Nowie69/Eindproject-Robot-6ICW/README.md

De mappen zijn verdeeld per deel, map voor de website, voor code van de controle etc
Per map staat er een document om te zien wat er gedaan moet worden.
In elke map staat er ook de code en nodige documenten om de code te doen werken.
