Nowie69/Eindproject-Robot-6ICW/WebsiteV2/-Sjabloon-/hardware.html

Home Hardware Software Over Ons GitHub project (https://github.com/Nowie69/Eindproject-Robot-6ICW)

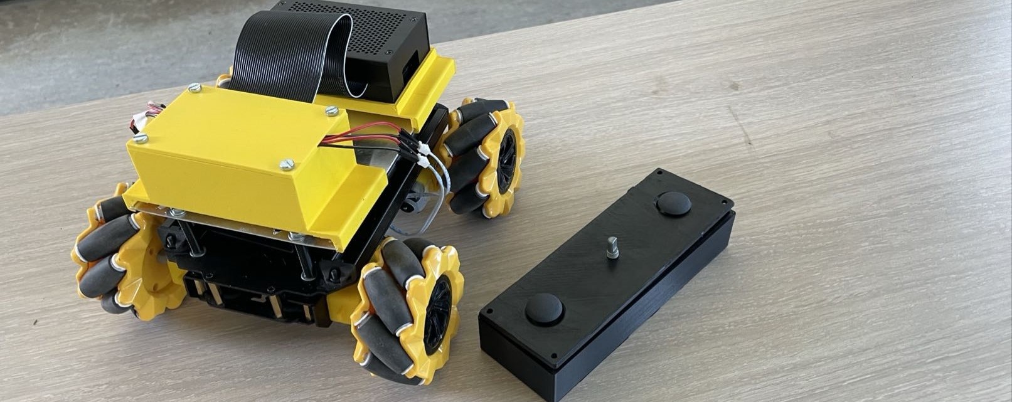
[picture p1: WebsiteV2/-Sjabloon-/images/bannerRobot.jpg]
bannerRobot


Hardware

# Uitleg van de hardware

De Robot
De Controller
De Laptop
De Router

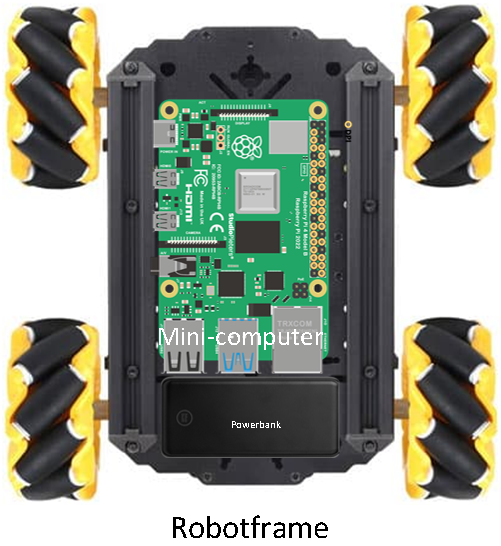
[picture p2: WebsiteV2/-Sjabloon-/images/blokschema frame.png]
blokschema frame


## De robot

De robot bestaat uit het chassis met de 4 DC-motoren en mecanum wielen, de powerbank, de Raspberry Pi en de H-bruggen.

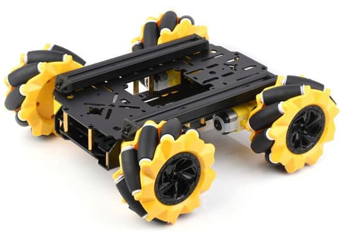
[picture p3: WebsiteV2/-Sjabloon-/images/chassis.png]
chassis


### Chassis met DC-motoren en mecanum wielen:

Het frame is gemaakt uit aluminium en daar is alles op bevestigd. Er zijn veel bevestigingspunten op het frame, zo is het gemakkelijk om alle elementen er stevig op te monteren.

De DC-motoren werken op een spanning tussen 3 en 12 volt, dat is ideaal want de Raspberry Pi kan een spanning leveren van 3,3V en 5V. Wij hebben er voor gekozen om de motoren met 5V te voeden.

Mecanum wielen zijn wielen met schuine rollen (meestal 45°) rondom de omtrek, waarmee voertuigen omnidirectioneel kunnen bewegen. Door de draairichting en snelheid van elk wiel apart aan te sturen, ontstaat voorwaartse, zijwaartse, diagonale of roterende beweging zonder de wielen te pivoteren.

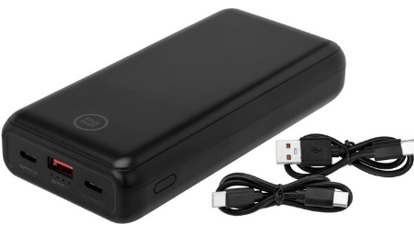
[picture p4: WebsiteV2/-Sjabloon-/images/powerbank.png]
powerbank


### De powerbank:

De powerbank zit bevestigd op het frame, deze geeft de Raspberry Pi zijn voeding.

De Raspberry Pi heeft 5 volt nodig met 3A-5A stroom (afhankelijk van de belasting van de Raspberry). de powerbank levert maximum 20W op 5V.

I=P/U=20W/5V=4A

Tijdens we de robot aan het testen waren, hebben we de motoren gevoed met een regelbare voeding. Deze gaf aan hoe hoog de stroom was, die waarde was toen maximum 2,5A. De powerbank levert dus ook voldoende voeding aan de Raspberry Pi.

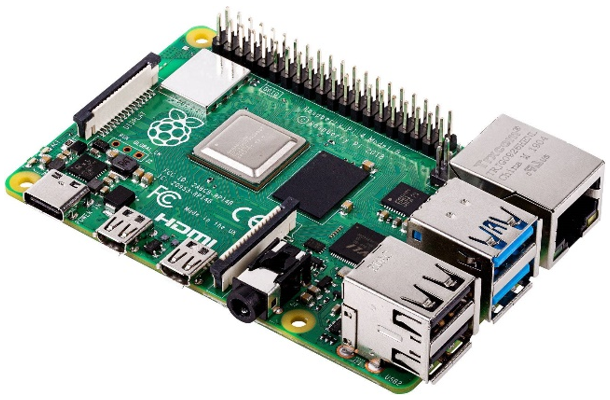
[picture p5: WebsiteV2/-Sjabloon-/images/RPI.png]
Raspberry Pi


### De Raspberry Pi:

Wij gebruiken de Raspberry Pi 4, het is een kleine computer die we met het WiFi-netwerk verbinden, zoals alle apparaten. Er draaien 2 programma’s op; node-red, waar alle MQTT-berichten worden verwerkt en zo de pinnen op de Raspberry Pi aansturen. Het tweede programma dat er op draait is mosquitto, een MQTT-broker dat gesubscribed is op de topics waar wij onze data naar sturen. Mosquitto ontvangt de berichten van publishers en stuurt ze door naar alle geïnteresseerde subscribers.

Op node-red hebben wij de topics gesubscribed, en deze zal node-red nadien ontvangen en verwerken. Het loopt door een JavaScript code om te weten welke pinnen er moeten aangestuurd worden voor de H-bruggen.

Omdat de Raspberry Pi verbonden is met hetzelfde WiFi-netwerk als de controller, kunnen ze op deze manier communiceren. De microcontroller maakt verbinding met het IP-adres van de Raspberry Pi (bijv. 192.168.1.50) via poort 1883 en stuurt berichten naar een topic.

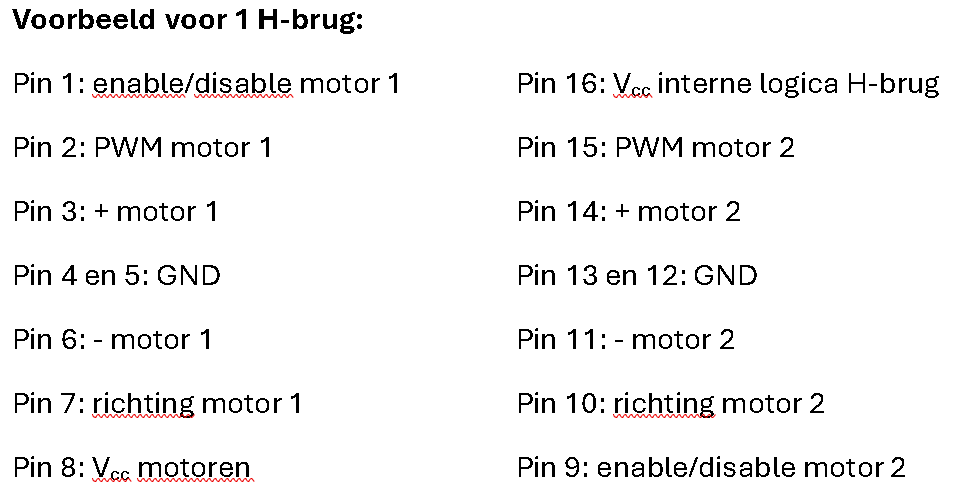
[picture p6: WebsiteV2/-Sjabloon-/images/voorbeeld aansluitingen 1 H-brug.png]
vb 1 H-brug


### De H-bruggen:

We maken gebruik van 2 H-bruggen (2 x L293D). Op elke H-brug zitten 2 DC-motoren aangesloten. Dit was voor ons de beste optie, we kunnen hiermee de motoren enablen/disablen, de richting bepalen en ook de snelheid door middel van een PWM signaal (de pin heel snel na elkaar hoog en laag maken, hoe langer het hoog is en hoe korter laag, hoe sneller de motor draait).

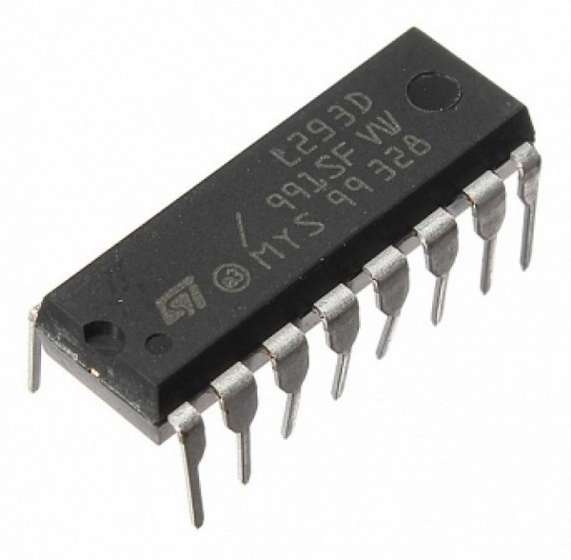
[picture p7: WebsiteV2/-Sjabloon-/images/L293D.jpg]
L293D


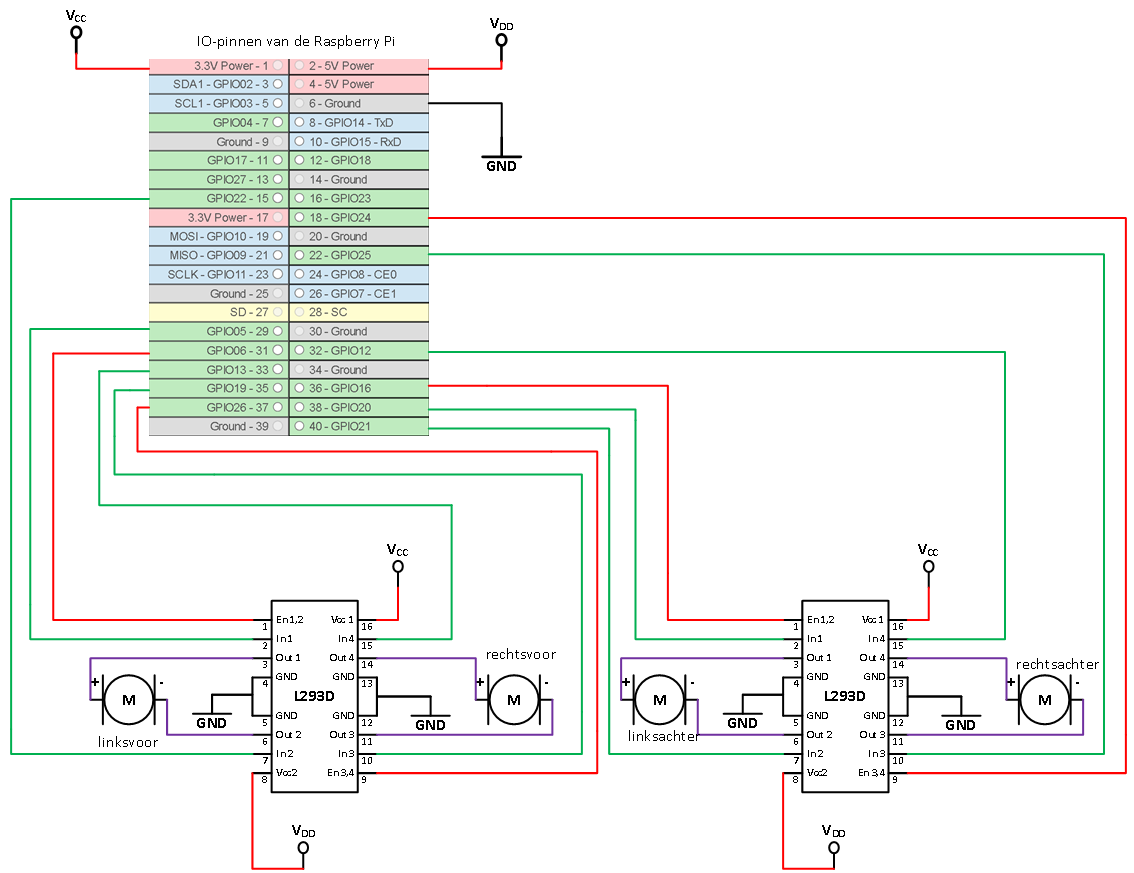
[picture p8: WebsiteV2/-Sjabloon-/images/schema H-bruggen.png]
schema H-bruggen


### Schema van de H-bruggen aan de Raspberry Pi:

Door de juiste pinnen hoog/laag/PWM in te stellen kan je de robot in elke horizontale richting laten rijden.

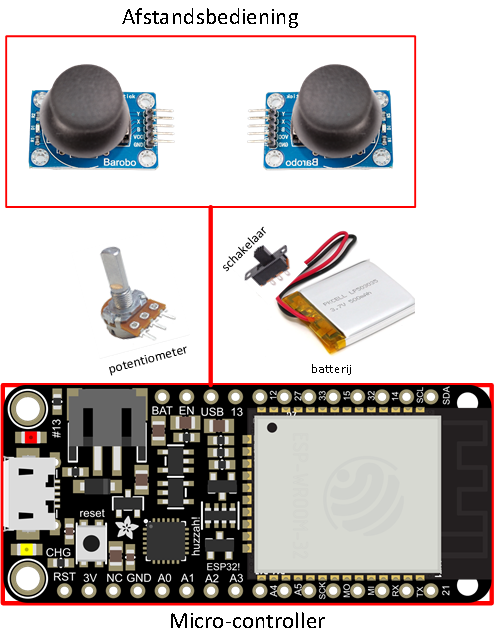
[picture p9: WebsiteV2/-Sjabloon-/images/blokschema controller.png]
blokschema controller


## De controller

De controller bestaat uit een ESP32 feather (Microcontroller), 2 joysticks, een potentiometer, een batterij en een dubbelpolige schakelaar.

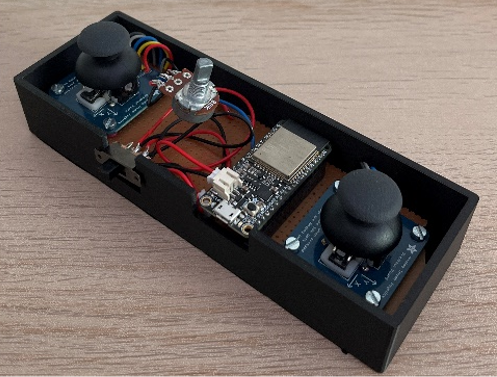
[picture p10: WebsiteV2/-Sjabloon-/images/controller.png]
controller


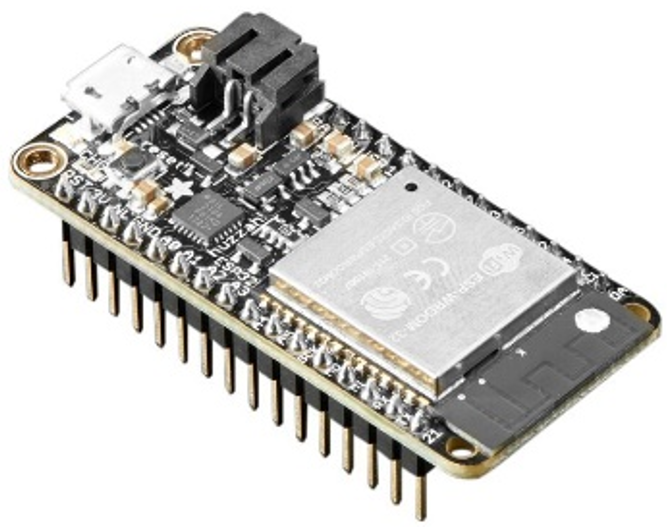
[picture p11: WebsiteV2/-Sjabloon-/images/ESP32.png]
ESP32


### De ESP32 Feather:

We maken gebruik van de ESP32 Feather van Adafruit, omdat deze microcontroler kan verbinden met WiFi, genoeg analoge ingangen heeft voor de joysticks en potentiometer, digitale ingangen voor de knop op de joysticks, deze kan verbinden met batterij, deze zeer snel en eenvoudig te programmeren is.

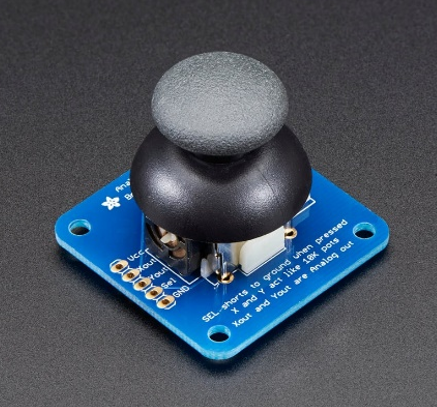
[picture p12: WebsiteV2/-Sjabloon-/images/joystick.png]
joystick


### De joysticks:

Voor de joysticks gebruiken we de analoge joysticks, ook van Adafruit. In elke joystick zitten 2 “potentiometers” van 10k Ohm, één voor de x-as en één voor de y-as. Elke joystick heeft 5 aansluitingen; Vcc voor de voeding (3,3V van de MC (Micro-Controller)), analoge uitgang voor de x-as, analoge uitgang voor de y-as, een digitale uitgang voor de knop van de joystick en een Ground.

De analoge uitgangen van de joysticks worden aangesloten op de analoge ingangen van de MC, de analoge ingang zet de analoge spanning om in een waarde tussen 0 en 4095 (12 bit), en zo weet je de positie in elke as. De digitale uitgangen van de joysticks worden aangesloten op een digitale ingang van de MC, deze leest een hoge of lage waarde (ingedrukt of niet).

De joysticks hebben ook 4 punten om deze makkelijk te bevestigen met afstandsbussen, bouten en moeren.

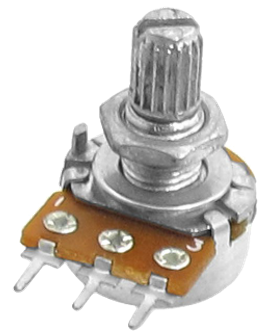
[picture p13: WebsiteV2/-Sjabloon-/images/potMeter.png]
potentiometer


### De potentiometer:

We maken gebruik van een simpele potentiometer van 10k Ohm. Deze heeft 3 aansluitingen; Vcc (3,3V van de MC), een loper om aan te sluiten op een analoge ingang van de microcontroller, en een Ground.

De MC zet de analoge spanning tussen 0 en 3,3V om in een waarde tussen 0 en 4095 (12 bit), en zo weet je hoe ver de potentiometer is gedraaid.

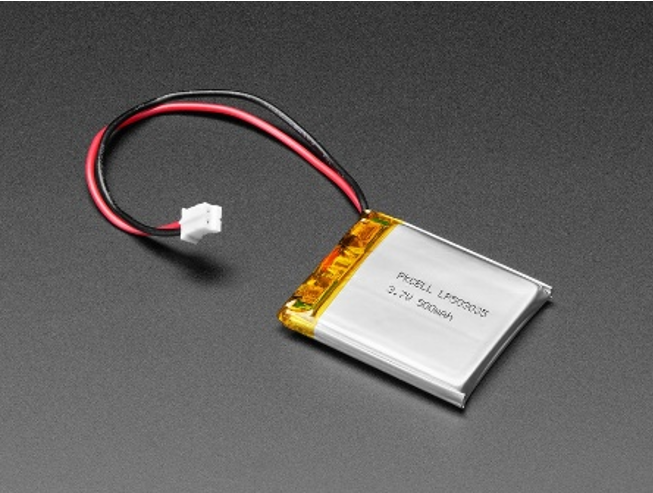
[picture p14: WebsiteV2/-Sjabloon-/images/batterij.png]
batterij


### De batterij:

De batterij is aangesloten op de JST pinnen op de MC, met daartussen een schakelaar. Als de MC is aangesloten met de USB-poort en de schakelaar is gesloten, kan de batterij opladen. Als je de schakelaar sluit dan geeft de batterij voeding aan de MC, zo kan je de robot besturen zonder kabels.

Het is een batterij van Adafruit, deze levert een spanning van 3,7V en heeft een capaciteit van 500mAh. Ideaal dus voor de MC en zijn componenten.

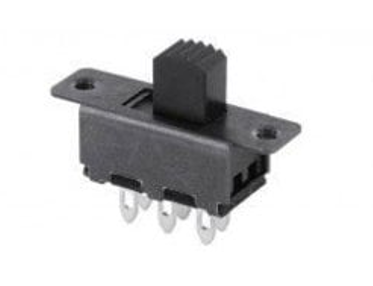
[picture p15: WebsiteV2/-Sjabloon-/images/schakelaar.png]
schakelaar


### De schakelaar:

De schakelaar staat geschakeld tussen de JST pinnen van de MC en de batterij. De dubbelpolige schakelaar connecteert beide draden van de batterij met de MC, zodat we zeker zijn dat er niks verloren gaat.

### Schema van de controller:

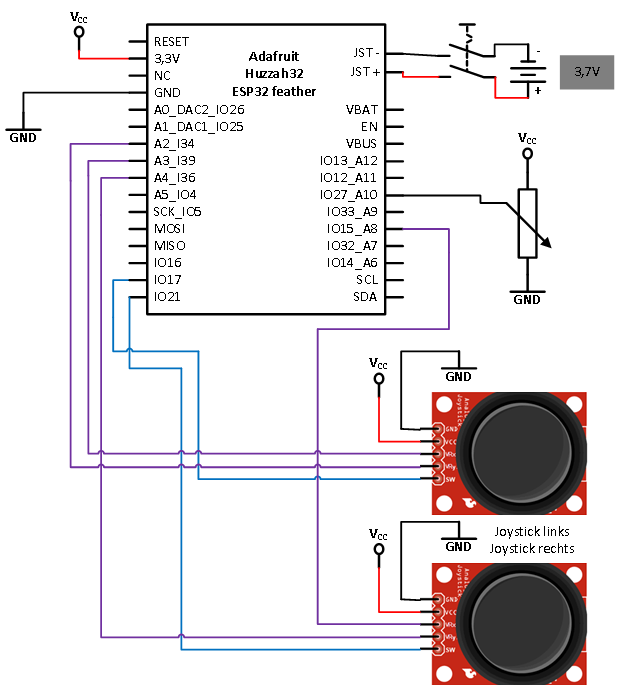
[picture p16: WebsiteV2/-Sjabloon-/images/schema controller.png]
schema controller


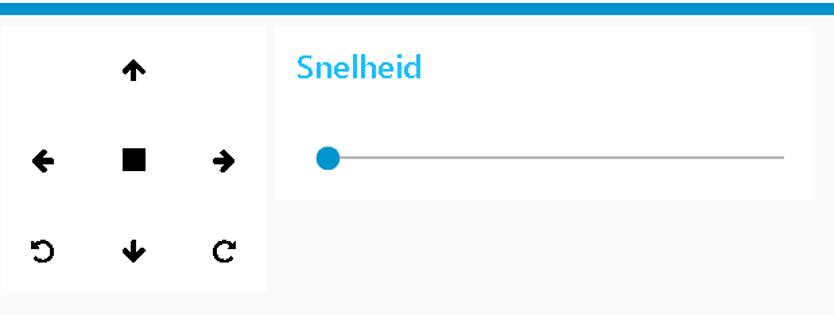
[picture p17: WebsiteV2/-Sjabloon-/images/blokschema dashboard.png]
dashboard


## De laptop

We gebruiken een laptop zodat we de robot ook kunnen besturen zonder controller, via een dashboard op node-red. We kunnen ook via MQTT explorer mqtt berichten sturen naar de robot.

Er draaien dus 2 programma’s op de laptop; node-red en MQTT explorer. Deze is ook verbonden met hetzelfde WiFi-netwerk als de MC en de Raspberry Pi, om via WiFi te communiceren. De MQTT explorer maakt verbinding met de broker en je kan er MQTT berichten lezen en versturen.

We hebben de laptop ook gebruikt om alles te programmeren en om alle schema’s, flowcharts en blokschema’s te maken.

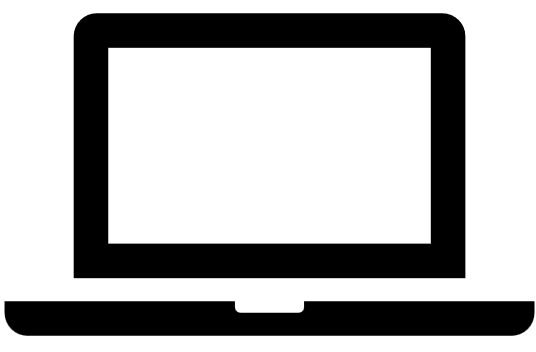
[picture p18: WebsiteV2/-Sjabloon-/images/laptop.png]
laptop


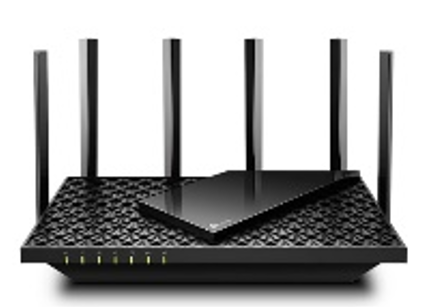
[picture p19: WebsiteV2/-Sjabloon-/images/router.png]
router


## De router

De router zorgt voor het WiFi netwerk waar alle apparaten mee zijn verbonden. Alle berichten en info passeert langst hier.

© 2025 Mecanum Robot. Alle rechten voorbehouden.
