Nowie69/Eindproject-Robot-6ICW/Robot met mecanum wheels.pptx

## Robot met mecanum wheels

Introductie

Onderzoekscompetentie
Noah Vermaerke & Wout Vandevelde

## Inhoud

- Algemene uitleg
- Demo
- Hardware
- Software
- Extra
- Afsluiter

Inhoud

## De werking

- Raspberry-pi
- WiFi
- ESP32-Feather
- Dashboard

Algemene uitleg

## Besturing van de robot

- 2 joysticks
- 8 rijrichtingen
- Rond as draaien
- Snelheid aanpassen

## Demo

Korte demonstratie van de robot

Demo

## Componenten

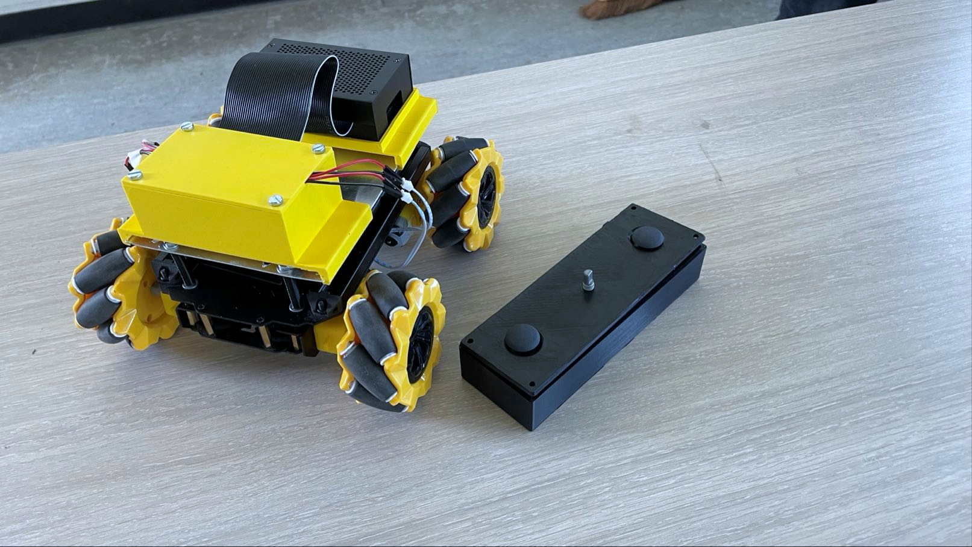
[picture p20: figure]
Afbeelding met wiel, speelgoed, band, Schaalmodel Door AI gegenereerde inhoud is mogelijk onjuist.

Component | Doel van het component | Component | Doel van het component
Raspberry-pi | Juiste aansturing naar DC-motoren | Schakelaar | Aan- en uitzetten controller
ESP32-Feather | Doorgeven van juiste waarden naar de Raspberry-pi voor besturen robot | H-bruggen | Zorgen juiste snelheid en draaikant van DC-motors
Laptop | Besturen robot via dashboard | Potentiometer | Zelf snelheid instellen van robot
DC-motors | Draaien en rijden | Batterij | Controller kunnen gebruiken zonder aangesloten op laptop
Joysticks | Besturen robot via controller | Powerbank | Voeding voorzien aan robot

Hardware

## Verbinding

- Router voor WiFi
- Solderen
  - Raspberry-pi
    - DC-motors → H-Bruggen → Raspberry-pi
  - ESP32-Feather
    - Joysticks → ESP32
    - Potentiometer → ESP32
    - Schakelaar → Batterij/ESP32

## Programma’s

- Node-Red → Raspberry-pi
- C++ (Arduino) → ESP32-Feather

Software

## ESP32-Feather

- Joysticks
- Potentiometer

## Schema ESP32-Feather

## Raspberry-pi

- H-bruggen
- DC-motoren

## Schema Raspberry pi

## Flowcharts

- 9 flowcharts
→1 declaratie
→ 1 setup
→7 methodes

Software

## Declaratie

## Declaratie

## Declaratie

## Verbinden WiFi

- Setup
- Methode

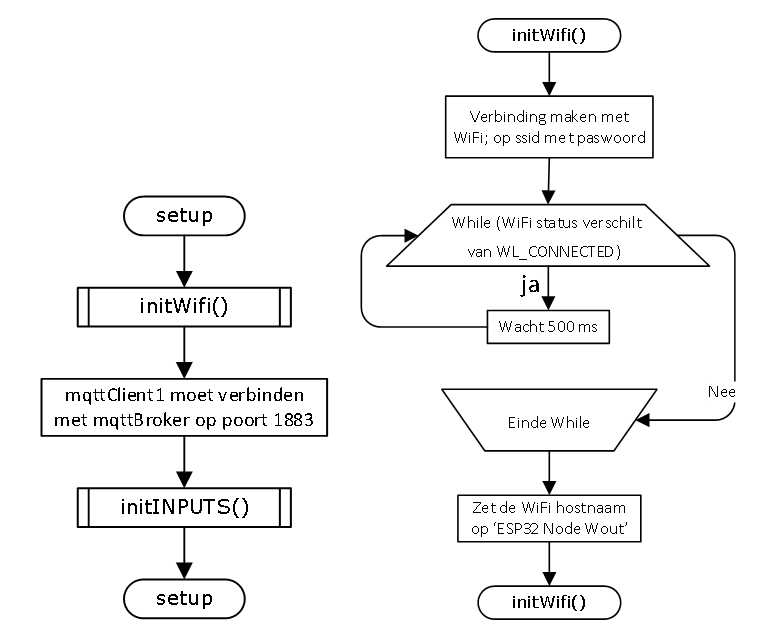
[picture p21: figure]

## Verbinden MQTT

## Inputs

## Afstandsbediening

## Dashboard

- Aansturen robot

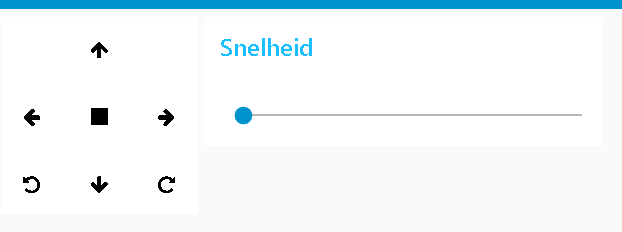
[picture p22: figure]
Afbeelding met tekst, schermopname, Lettertype, ontwerp Door AI gegenereerde inhoud is mogelijk onjuist.

## Website

- Waarom?
  - Uitleg geven over robot
- Programmeertaal
  - HTML
  - CSS

Extra

## Einde

Zijn er nog vragen?

Afsluiter
