Nowie69/Eindproject-Robot-6ICW/WebsiteV2/-Sjabloon-/flowchart controller.pdf

loop

loop

if
(mqttCLient1 is niet
connected) | Ja

Nee

mqttConnect()

houdt de MQTT-verbinding actief en verwerkt binnenkomende berichten met mqttClient1.loop

afstandsbediening()

initWifi()

initWifi()

Verbinding maken met
WiFi; op ssid met paswoord

Nee

While (WiFi status verschilt van WL_CONNECTED)

Einde While

ja

Wacht 500 ms

Zet de WiFi hostnaam
op ‘ESP32 Node Wout’

setup

setup

initWifi()

initINPUTS()

mqttClient1 moet verbinden met mqttBroker op poort 1883

initINPUTS()

initINPUTS()

Pinmode van PosXL
instellen als INPUT

Pinmode van PosYL
instellen als INPUT

Pinmode van PosXR
instellen als INPUT

Pinmode van PosYR
instellen als INPUT

Pinmode van ButtonL
instellen als INPUT_PULLUP

Pinmode van ButtonR
instellen als INPUT_PULLUP

Pinmode van PotSnelheid
instellen als INPUT

readINPUTS()

Lees analoog de waarde van pin “PosXL” en plaats die in “intWaardeXL” Lees analoog de waarde van pin “PosYL” en plaats die in “intWaardeYL” Lees analoog de waarde van pin “PosXR” en plaats die in “intWaardeXR” Lees analoog de waarde van pin “PosYR” en plaats die in “intWaardeYR” Lees digitaal de waarde van pin “ButtonL” en plaats die in “blButtonL” Lees digitaal de waarde van pin “ButtonR” en plaats die in “blButtonR”

readINPUTS()

Alle ingangen lezen en de waardes in variabelen plaatsen

Ja

Nee

loop

Sketch

Sketch

setup

While (1)

Einde While

Declaraties()

mqttConnect()

Nee

While (mqttClient1 is niet connected)

Einde While

if
(de verbinding is
gemaakt)

Nee

Ja

Wacht 5
seconden

mqttConnect()

Maak verbinding met MQTT

ja

## PosYL gelinkt aan pin A2 PosXL gelinkt aan pin A3 ButtonL gelinkt aan pin 17 PosYR gelinkt aan pin A4 PosXR gelinkt aan pin 32 PotSnelheid gelinkt aan pin 33

## Duidelijke namen geven aan de pinnen op de ESP32 Feather

## De constante integer ‘DeadzoneMIN’ aanmaken en een is 1200 De constante integer ‘DeadzoneMAX’ aanmaken en een is 2300

## Dit gebruiken we later om de deadzone van de joysticks in te stellen

## De methode ’mqttConnect’ declareren De methode ’initWifi’ declareren De methode ‘afstandsbediening’ declareren De methode ‘initINPUTS’ declareren De methode ‘readINPUTS’ declareren

## De methodes worden nu gedeclareerd en later gebruikt

## De constante char* ‘ssid’ aanmaken en naam van het WiFi-netwerk erin steken De constante char* ‘paswoord’ aanmaken en paswoord van het WiFi-netwerk erin steken ‘WifiClient1’ aanmaken van de klasse WifiClient

## De WiFi-instellingen

De constante char* ‘mqttBroker’ aanmaken en IP van de broker erin steken De constante char* ‘mqttClientName’ aanmaken en ‘Wout’ er in steken De constante char* ‘mqttPwd’ aanmaken en het paswoord er in steken van de broker De constante char* ‘clientID’ aanmaken en de client naam er in steken van de broker Object aanmaken van type ‘PubSubClient’ met naam ‘mqttClient1’, en geeft ‘WiFiClient1’ mee

aan constructor.

## De MQTT-instellingen

## De constante char* ‘PubRichting’ aanmaken en ‘Robot/Richting’ er in steken De constante char* ‘PubDraaien’ aanmaken en ‘Robot/Draaien’ er in steken De constante char* ‘PubSnelheid’ aanmaken en ‘Robot/Snelheid’ er in steken

## Naam van de topic waarop data verstuurd wordt (publish)

## Integer ‘intWaardeXL’ aanmaken Integer ‘intWaardeYL’ aanmaken Boolean ‘blButtonL’ aanmaken Integer ‘intWaardeXR’ aanmaken Integer ‘intWaardeYR’ aanmaken Boolean ‘blButtonR’ aanmaken Integer ‘intAnalogSnelheid’ aanmaken

## Variabelen van de joysticks

## Declaraties()

## Declaraties()

Afstandsbediening()

Boolean “blLinks” aangemaakt en false gemaakt Boolean “blRechts” aangemaakt en false gemaakt Boolean “blVooruit” aangemaakt en false gemaakt Boolean “blAchteruit” aangemaakt en false gemaakt Boolean “blDraaiLinks” aangemaakt en false gemaakt Boolean “blDraaiRechts” aangemaakt en false gemaakt Boolean “blLinksVooruit” aangemaakt en false gemaakt Boolean “blRechtsVooruit” aangemaakt en false gemaakt Boolean “blLinksAchteruit” aangemaakt en false gemaakt Boolean “blRechtsAchteruit” aangemaakt en false gemaakt

readINPUTS()

Alle variabelen aanmaken en op false plaatsen

Methode om de inputs te laten lezen

Integer “intPWMPercent”
aanmaken

Vorm de waarde van “intAnalogSnelheid” om van 0-4095 naar 0-100
En plaats deze in “intPWMPercent”

Percentage van hoelang het PWM signaal moet hoog zijn Dit is de snelheid van de robot

String “strPWMPercent”
aanmaken

“intPWMPercetn” omvormen naar een string en in “strPWMPercent” plaatsen

De string is makkelijker te versturen via MQTT

Publish op topic “PubSnelheid” de waarde van “strPWMPercent” met mqttClient1 via MQTT

if
(“intWaardeXL” is kleiner dan “DeadzoneMIN”)

Nee

Ja

“blAchteruit” true maken

Else if
(“intWaardeXL” is groter dan
“DeadzoneMAX”)

Ja

“blVooruit” true maken Nee

Else if
(“intWaardeYL” is kleiner dan
“DeadzoneMIN”)

Else if
(“intWaardeYL” is groter dan “DeadzoneMAX”)

Nee

Else if
(“intWaardeYR” is kleiner dan “DeadzoneMIN”)

Nee

Else if
(“intWaardeYR” is groter dan “DeadzoneMAX”)

Nee

Ja

Ja

Ja

Ja

“blRechts” true maken

“blLinks” true maken

“blDraaiRechts” true maken

“blDraaiLinks” true maken

if
(“blVooruit” is true en
“blLinks” is true)

Nee

Ja

“blLinksVooruit” true maken “blDraaiLinks” false maken “blDraaiRechts” false maken “blLinks” false maken
“blVooruit” false maken

De richtingen van de joysticks in een boolean plaatsen
Elke richting true/false

De richting van de robot bepalen aan de hand van de richtingen van de joysticks (vorige if-else-….)

Nee
Publish op topic “PubRichting” ‘Rij Linksvooruit’ met mqttClient1 via MQTT

if
(“blVooruit” is true en
“blRechts” is true)

Ja

“blRechtsVooruit” true maken “blDraaiLinks” false maken “blDraaiRechts” false maken “blRechts” false maken
“blVooruit” false maken

Publish op topic “PubRichting” ‘Rij RechtsVooruit’ met mqttClient1 via MQTT

Nee

if
(“blAchteruit” is true en
“blLinks” is true)

“blLinksAchteruit” true maken “blDraaiLinks” false maken “blDraaiRechts” false maken “blLinks” false maken
“blAchteruit” false maken

Ja

Publish op topic “PubRichting” ‘Rij LinksAchteruit’ met mqttClient1 via MQTT

Nee

if
(“blAchteruit” is true en
“blRechts” is true)

“blRechtsAchteruit” true maken “blDraaiLinks” false maken “blDraaiRechts” false maken “blRechts” false maken
“blAchteruit” false maken

Ja

Publish op topic “PubRichting” ‘Rij RechtsAchteruit’ met mqttClient1 via MQTT

Nee

if
(“blLinks” is
true)

Ja

Else if
(“blRechts” is
true)

Else if
(“blVooruit” is
true)

Nee

Nee

Nee

Else if
(“blAchteruit” is
true)

Ja

Ja

Ja

Nee

if
(“blDraaiLinks”
is true)

Ja

Nee

Else if
(“blDraaiRechts”
is true)

Ja

Nee

Publish op topic “PubRichting” ‘Rij Links’ met mqttClient1 via MQTT

Publish op topic “PubRichting” ‘Rij Rechts’ met mqttClient1 via MQTT

Publish op topic “PubRichting” ‘Rij Vooruit’ met mqttClient1 via MQTT

Publish op topic “PubRichting” ‘Rij Achteruit’ met mqttClient1 via MQTT

Publish op topic “PubDraaien” ‘Draai links’ met mqttClient1 via MQTT

Publish op topic “PubDraaien” ‘Draai rechts’ met mqttClient1 via MQTT

if
(“blRechtsAchteruit” is false en “blLinksAchteruit” is false en “blRechtsVooruit” is false en “blLinksVooruit” is false en “blDraaiRechts” is false en “blDraaiLinks” is false en “blAchteruit” is false en “blVooruit” is false en “blRechts” is false en “blLinks” is false)
Publish op topic “PubRichting” ‘STOP’ met mqttClient1 via MQTT

Ja

Publish op topic “PubDraaien” ‘STOP’ met mqttClient1 via MQTT
Nee

Wacht 100 milliseconden

Afstandsbediening()

Als er geen richting is geselecteerd met de joysticks,

## Zend dan STOP door zodat de robot stopt
