Nowie69/Eindproject-Robot-6ICW/Datasheats en schema's/Taak 03 - Schema's van het onderzoeksproject - robot met mecanum wheels.docx

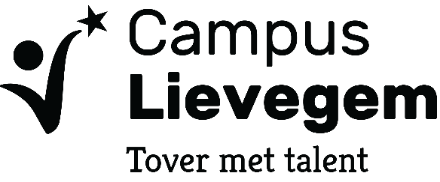
[picture p23: figure]

| | Bovenbouw SL Dreef 47 • 9930 LIEVEGEM
| | Vak: Onderzoekscompetentie Leerplan: D/2023/13.758 | Vakleraar: Deuninck T. Datum: ____ /____ /_______

### Project : robot met mecanum wheels Klas : 6ICW Klasnr : 5&6

Naam : Wout Vandevelde Naam : Noah Vermaerke
Taak 03 | Schema’s opdracht V1 | | | Punten : ___/10

1) | Plaats hieronder de schema’s van de hardware die je gaat gebruiken, bouwen, … voor het onderzoeksproject.

# Schema van het project

Op het robotframe: huskylens

## De afstandsbediening:

Taak 3 Schema’s opdracht V1 Pagina 1 van 1

Taak 3 Schema’s opdracht V1 Pagina 1 van 5
