Nowie69/Eindproject-Robot-6ICW/Datasheats en schema's/Topics MQTT.docx

# Topics

Robot/Richting → Er wordt een string doorgestuurd via MQTT waar de richting in staat

Robot/Draaien → Er wordt een string doorgestuurd via MQTT waar in staar of hij moet draaien

Robot/Snelheid → Er wordt een integer doorgestuurd via MQTT waar een waarde van 0 tot 100 wordt doorgestuurd
