Nowie69/Eindproject-Robot-6ICW/WebsiteV2/-Sjabloon-/images/afstandsbediening.png

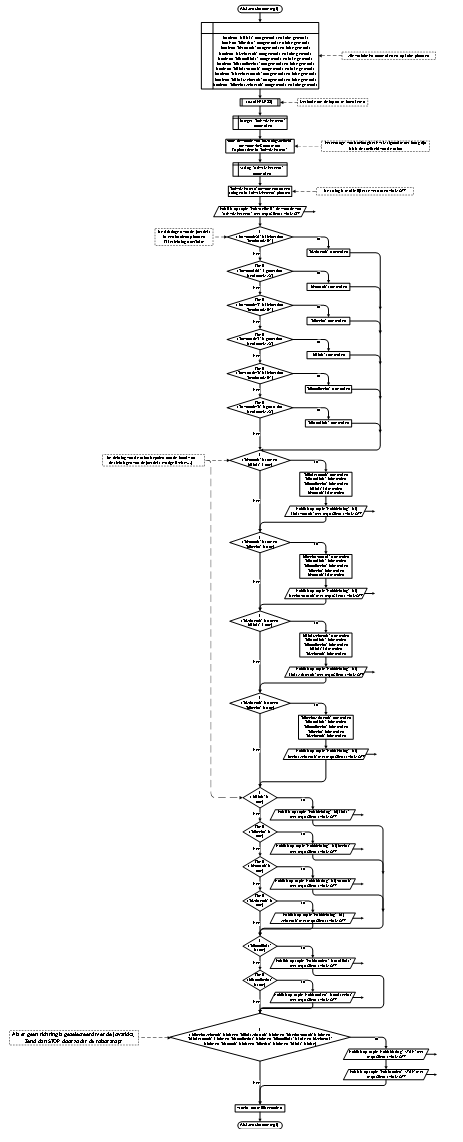
WebsiteV2/-Sjabloon-/images/afstandsbediening.png
