Nowie69/Eindproject-Robot-6ICW/WebsiteV2/-Sjabloon-/images/afstandsbedieningDEEL3.png

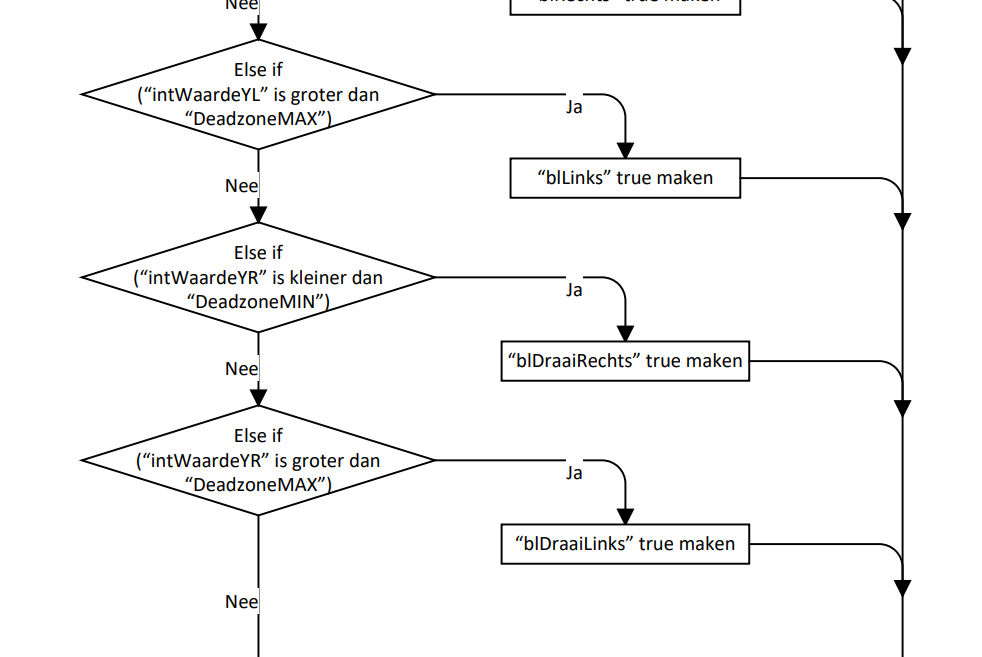
WebsiteV2/-Sjabloon-/images/afstandsbedieningDEEL3.png
