Nowie69/Eindproject-Robot-6ICW/WebsiteV2/-Sjabloon-/images/afstandsbedieningDEEL7.png

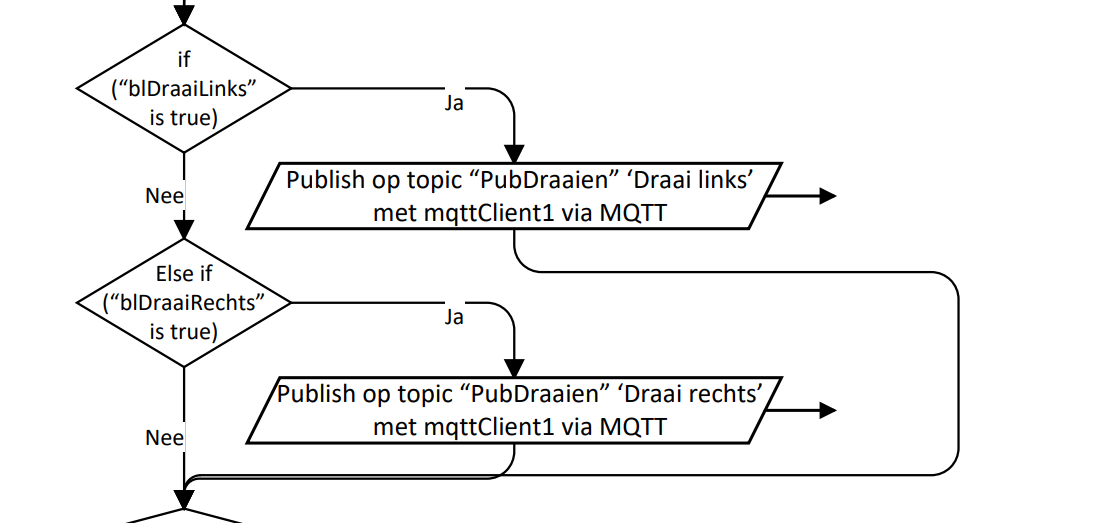
WebsiteV2/-Sjabloon-/images/afstandsbedieningDEEL7.png
