Nowie69/Eindproject-Robot-6ICW/WebsiteV2/-Sjabloon-/images/afstandsbedieningDEEL8.png

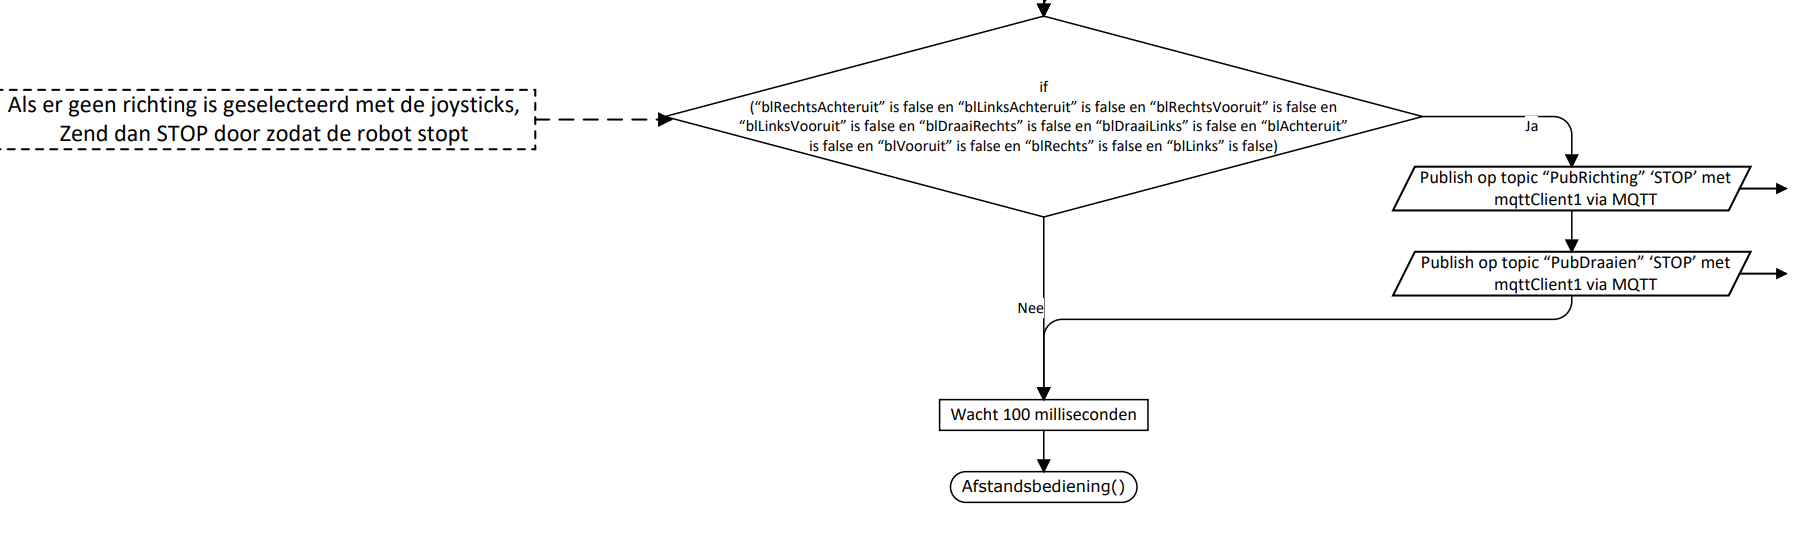
WebsiteV2/-Sjabloon-/images/afstandsbedieningDEEL8.png
