Nowie69/Eindproject-Robot-6ICW/WebsiteV2/-Sjabloon-/images/blokschema.png

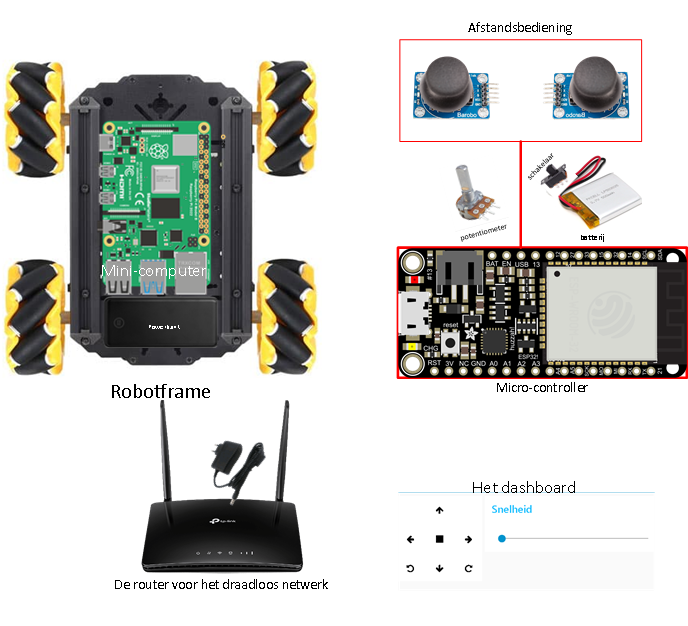
WebsiteV2/-Sjabloon-/images/blokschema.png
