Nowie69/Eindproject-Robot-6ICW/WebsiteV2/-Sjabloon-/images/DJ woody.png

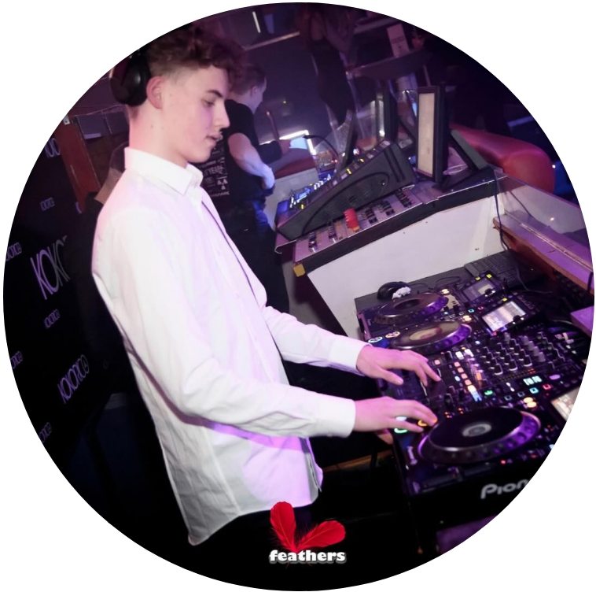
WebsiteV2/-Sjabloon-/images/DJ woody.png
