Nowie69/Eindproject-Robot-6ICW/WebsiteV2/-Sjabloon-/images/flowDeclaraties.png

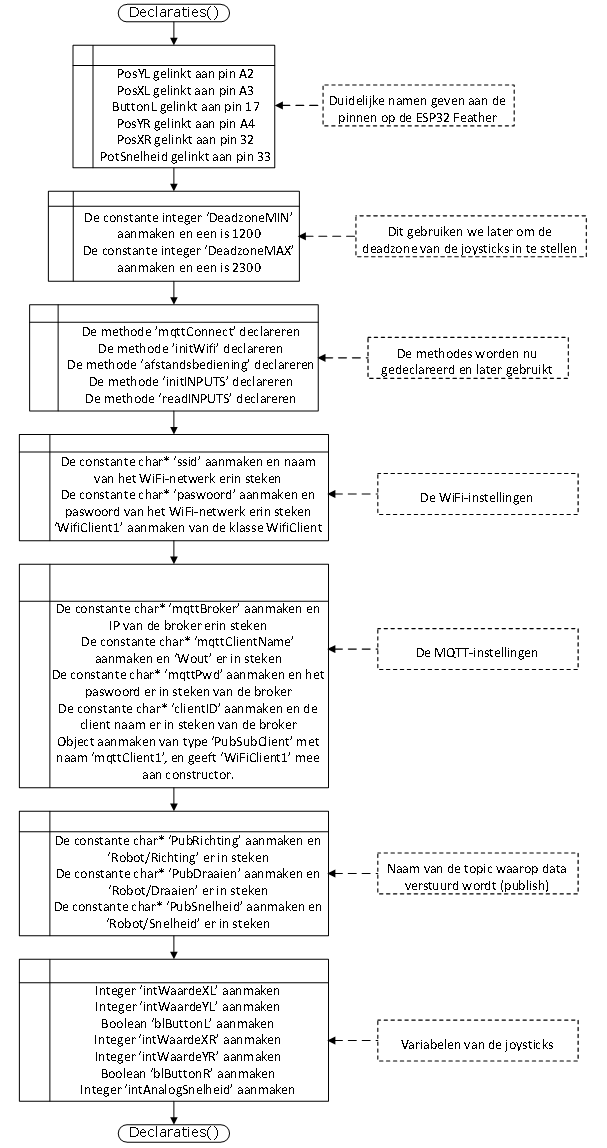
WebsiteV2/-Sjabloon-/images/flowDeclaraties.png
