Nowie69/Eindproject-Robot-6ICW/WebsiteV2/-Sjabloon-/images/initINPUTS.png

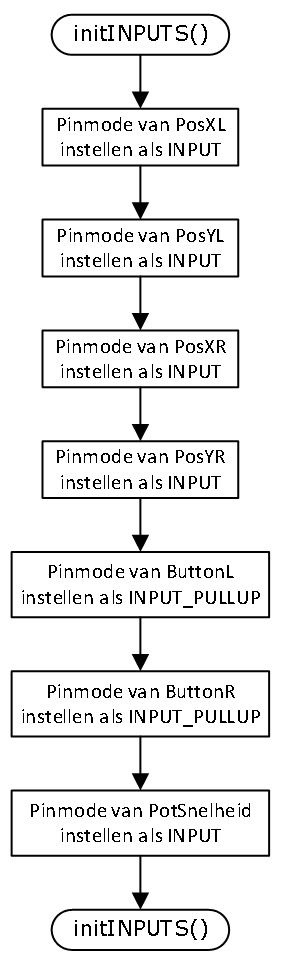
WebsiteV2/-Sjabloon-/images/initINPUTS.png
