Nowie69/Eindproject-Robot-6ICW/WebsiteV2/-Sjabloon-/images/initWifi.png

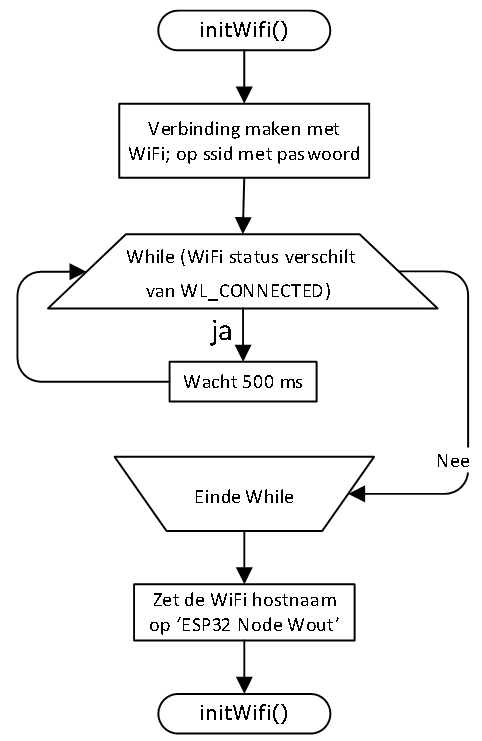
WebsiteV2/-Sjabloon-/images/initWifi.png
