Nowie69/Eindproject-Robot-6ICW/WebsiteV2/-Sjabloon-/images/loop.png

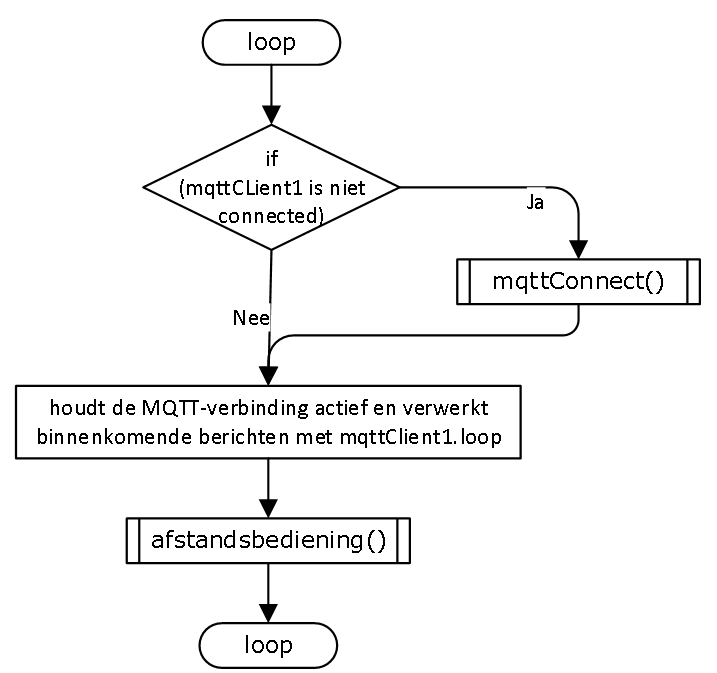
WebsiteV2/-Sjabloon-/images/loop.png
