Nowie69/Eindproject-Robot-6ICW/WebsiteV2/-Sjabloon-/images/mqttConnect.png

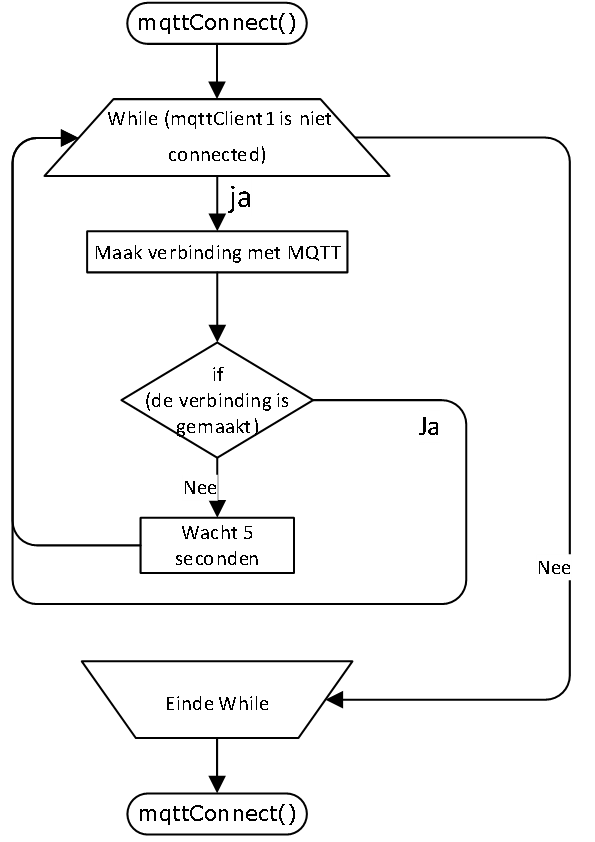
WebsiteV2/-Sjabloon-/images/mqttConnect.png
