Nowie69/Eindproject-Robot-6ICW/WebsiteV2/-Sjabloon-/images/MQTTExplorer.png

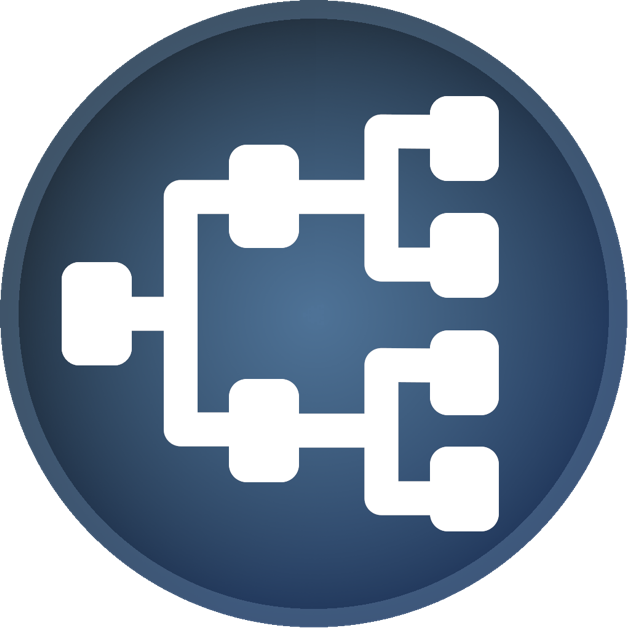
WebsiteV2/-Sjabloon-/images/MQTTExplorer.png
