Nowie69/Eindproject-Robot-6ICW/WebsiteV2/-Sjabloon-/images/noahtje.png

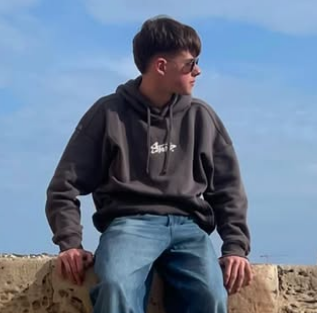
WebsiteV2/-Sjabloon-/images/noahtje.png
