Nowie69/Eindproject-Robot-6ICW/WebsiteV2/-Sjabloon-/images/Node-redFlow Laptop.png

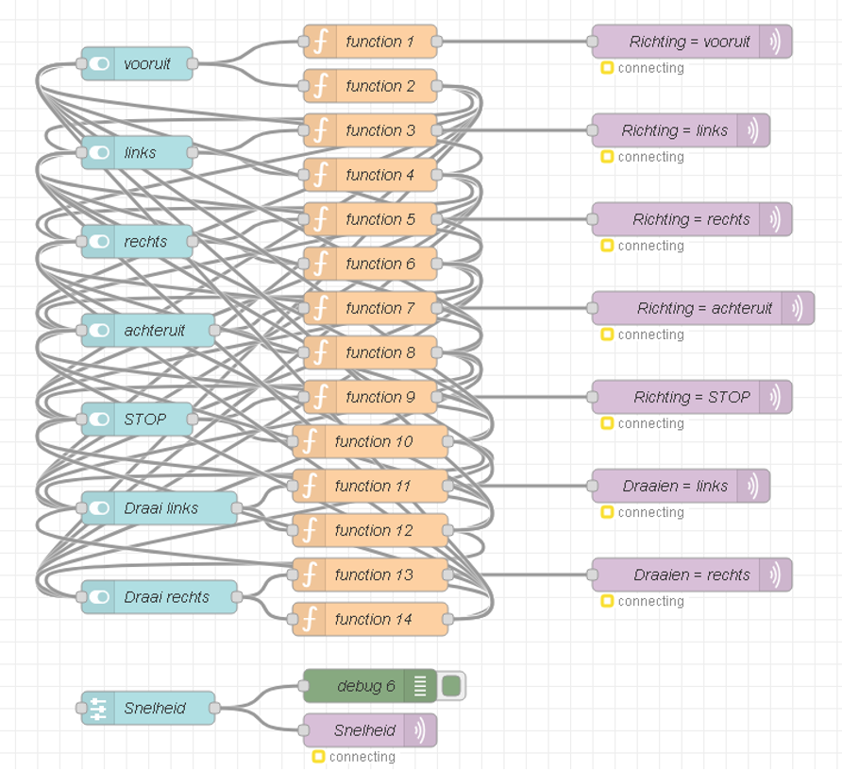
WebsiteV2/-Sjabloon-/images/Node-redFlow Laptop.png
