Nowie69/Eindproject-Robot-6ICW/WebsiteV2/-Sjabloon-/images/Node-redFlowRPI.png

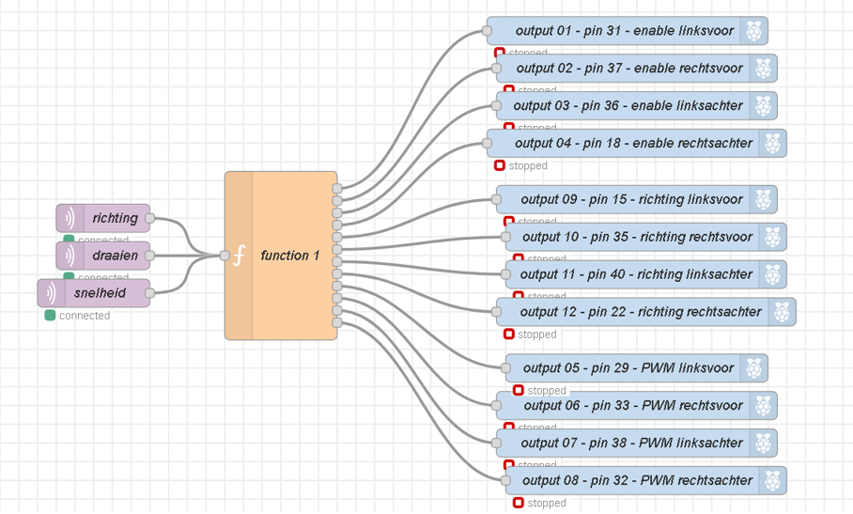
WebsiteV2/-Sjabloon-/images/Node-redFlowRPI.png
