Nowie69/Eindproject-Robot-6ICW/WebsiteV2/-Sjabloon-/images/readINPUTS.png

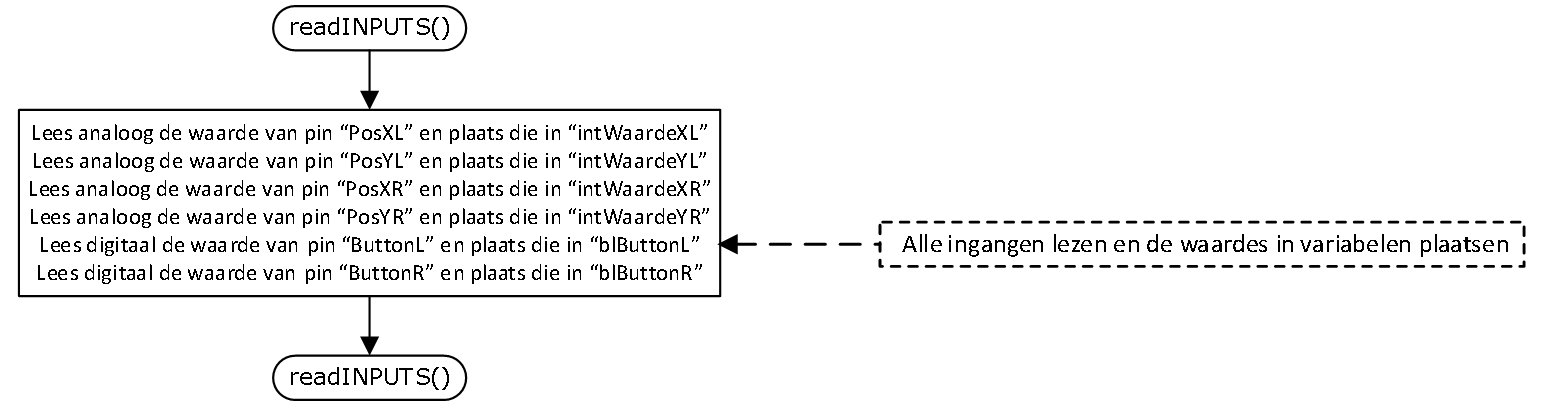
WebsiteV2/-Sjabloon-/images/readINPUTS.png
