Nowie69/Eindproject-Robot-6ICW/WebsiteV2/-Sjabloon-/images/robot.jpg

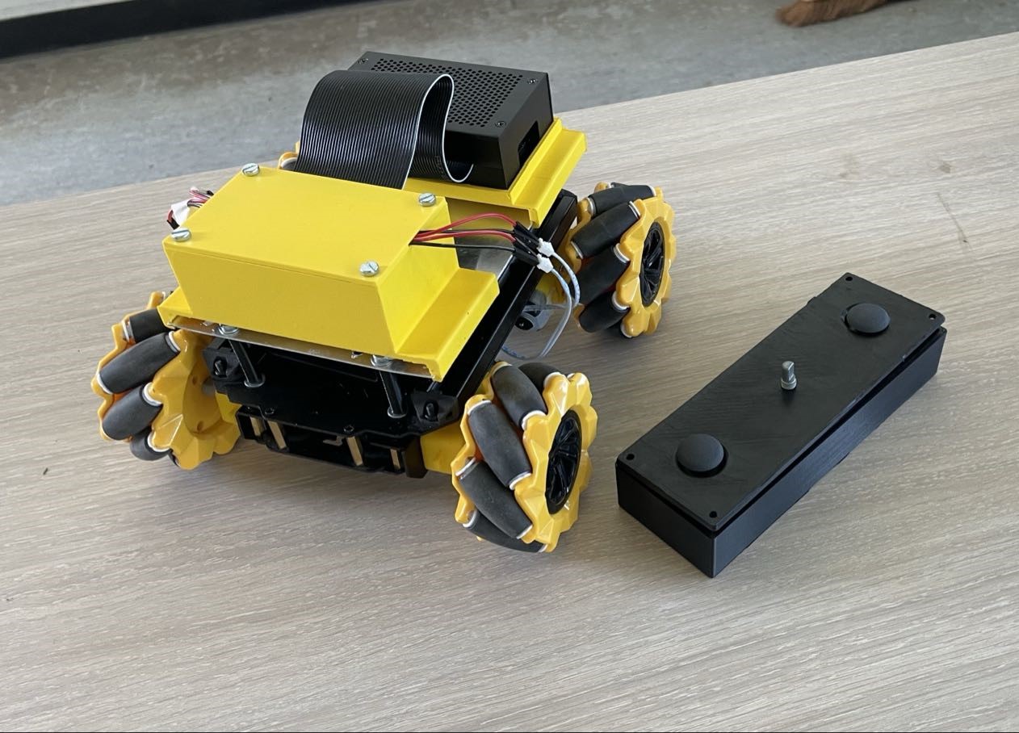
WebsiteV2/-Sjabloon-/images/robot.jpg
