Nowie69/Eindproject-Robot-6ICW/WebsiteV2/-Sjabloon-/images/sketch.png

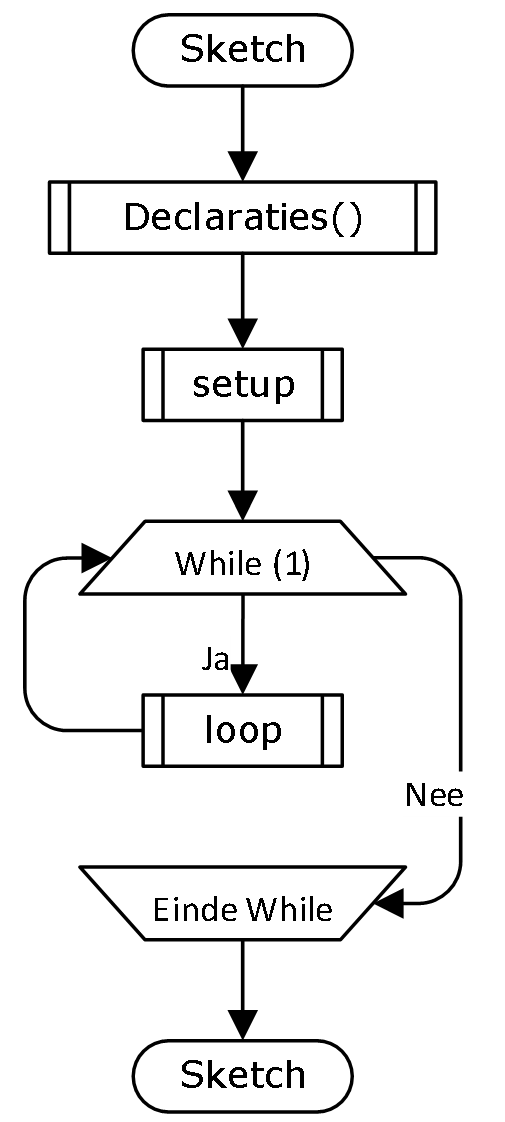
WebsiteV2/-Sjabloon-/images/sketch.png
