Nowie69/Eindproject-Robot-6ICW/Inventor tekeningen/POTknop.stl

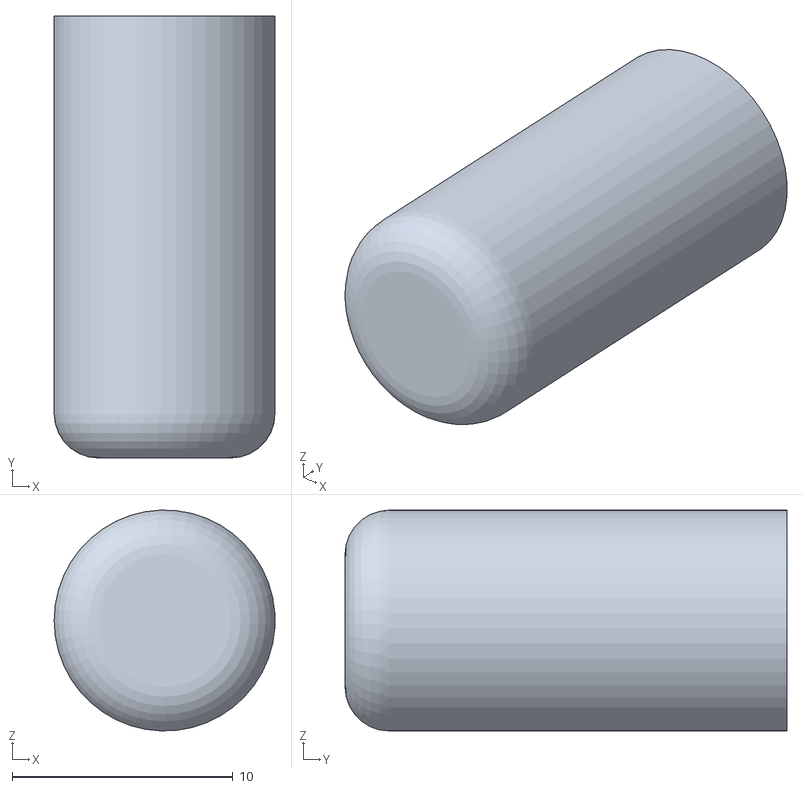
[picture p47: CAD file, 2025-05-27]
Inventor tekeningen/POTknop.stl
9.99 x 20.0 x 9.99
