Nowie69/Eindproject-Robot-6ICW/Inventor tekeningen/DekselHBruggen.stl

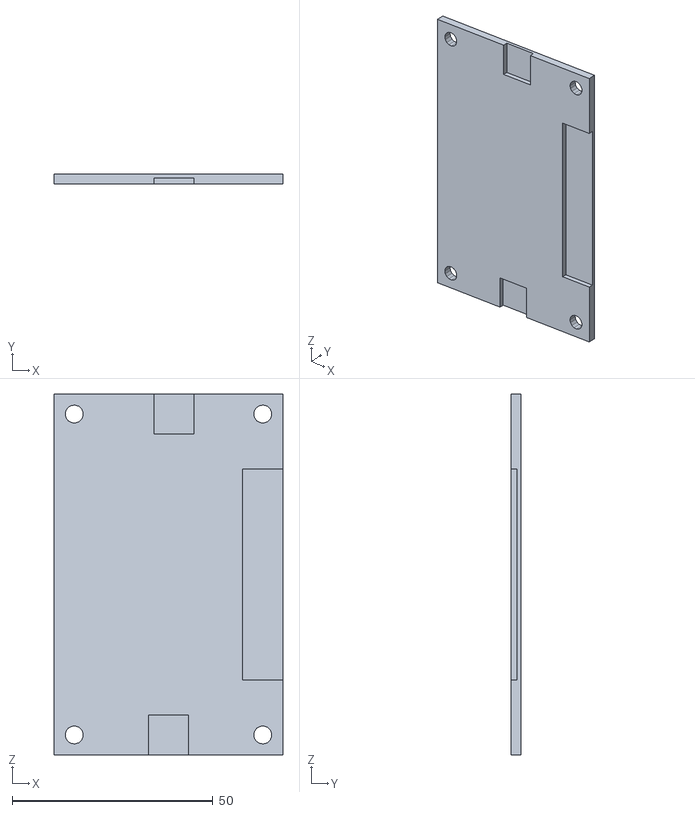
[picture p48: CAD file, 2025-05-12]
Inventor tekeningen/DekselHBruggen.stl
57.0 x 2.50 x 90.0
