Nowie69/Eindproject-Robot-6ICW/Inventor tekeningen/HouderHBruggen.stl

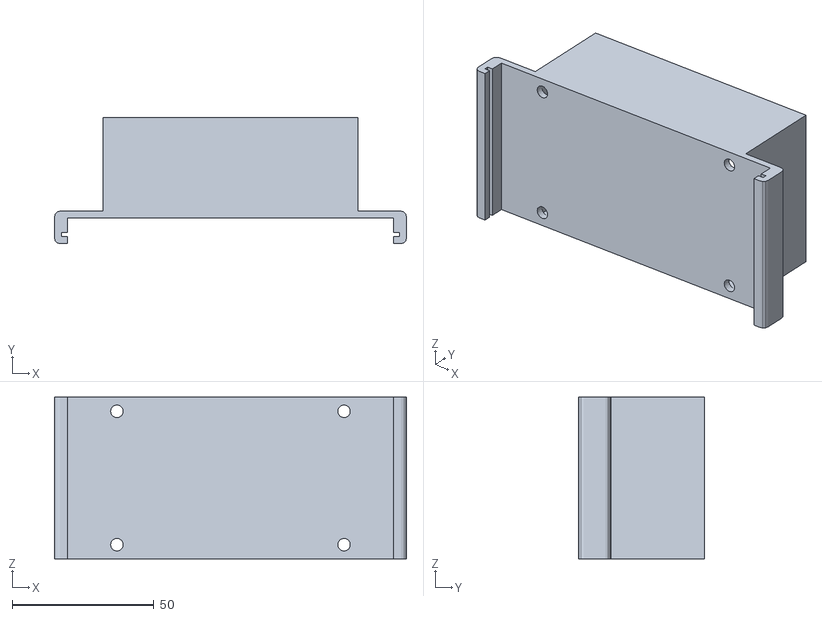
[picture p49: CAD file, 2025-05-07]
Inventor tekeningen/HouderHBruggen.stl
124.0 x 44.5 x 57.0
