Nowie69/Eindproject-Robot-6ICW/Inventor tekeningen/HouderRaspberryPi.stl

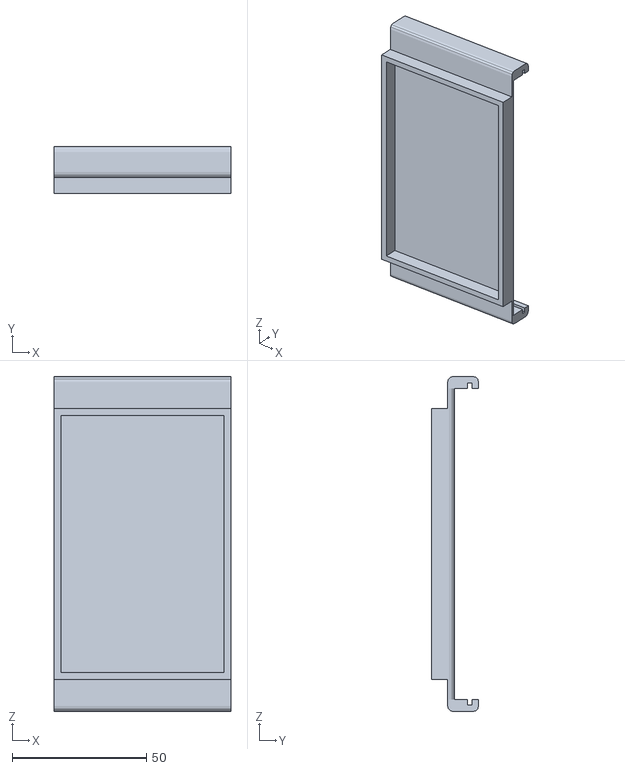
[picture p50: CAD file, 2025-05-07]
Inventor tekeningen/HouderRaspberryPi.stl
66.0 x 17.5 x 125.0
