Nowie69/Eindproject-Robot-6ICW/Inventor tekeningen/knob.stl

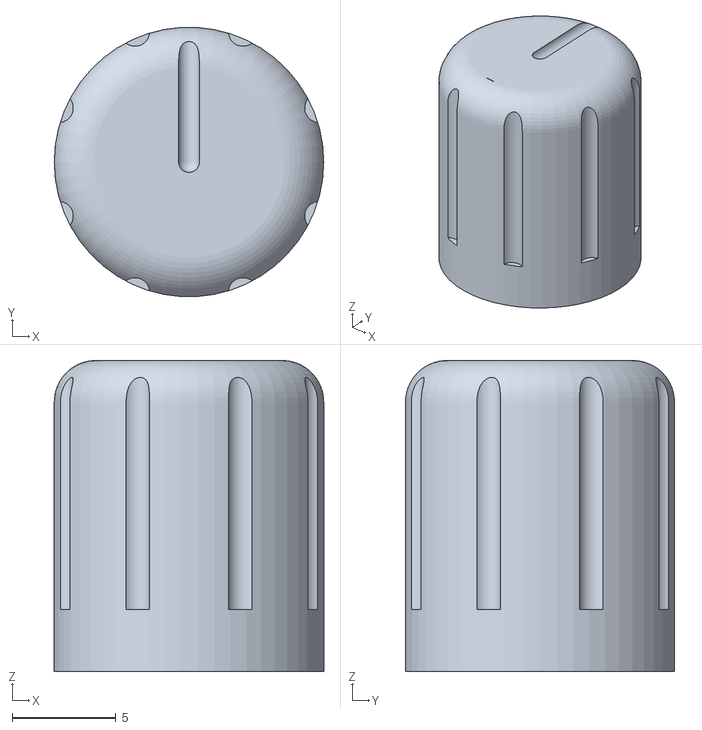
[picture p51: CAD file, 2025-03-29]
Inventor tekeningen/knob.stl
13.0 x 13.0 x 15.0
