Nowie69/Eindproject-Robot-6ICW/Inventor tekeningen/afstandsbus 30mm.stl4MM.stl

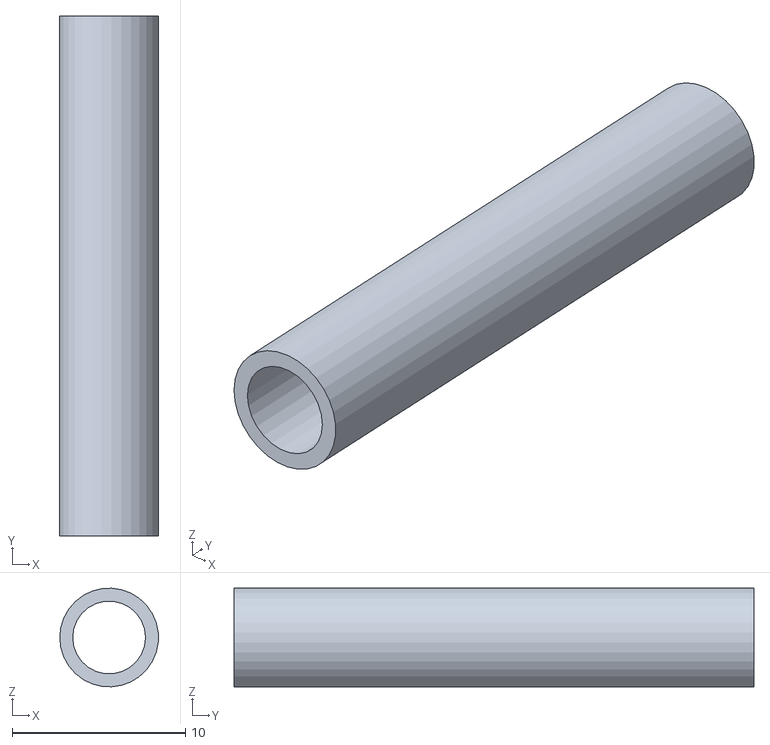
[picture p52: CAD file, 2025-03-24]
Inventor tekeningen/afstandsbus 30mm.stl4MM.stl
5.69 x 30.0 x 5.69
