Nowie69/Eindproject-Robot-6ICW/Inventor tekeningen/afstandsbus 30mm.stl

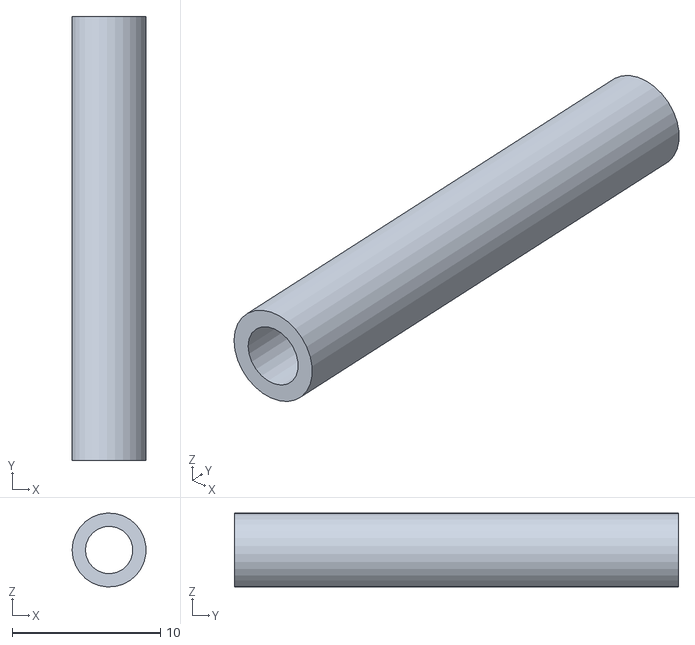
[picture p53: CAD file, 2025-03-24]
Inventor tekeningen/afstandsbus 30mm.stl
4.99 x 30.0 x 4.99
