Nowie69/Eindproject-Robot-6ICW/Inventor tekeningen/afstandsbediening bakje.stl

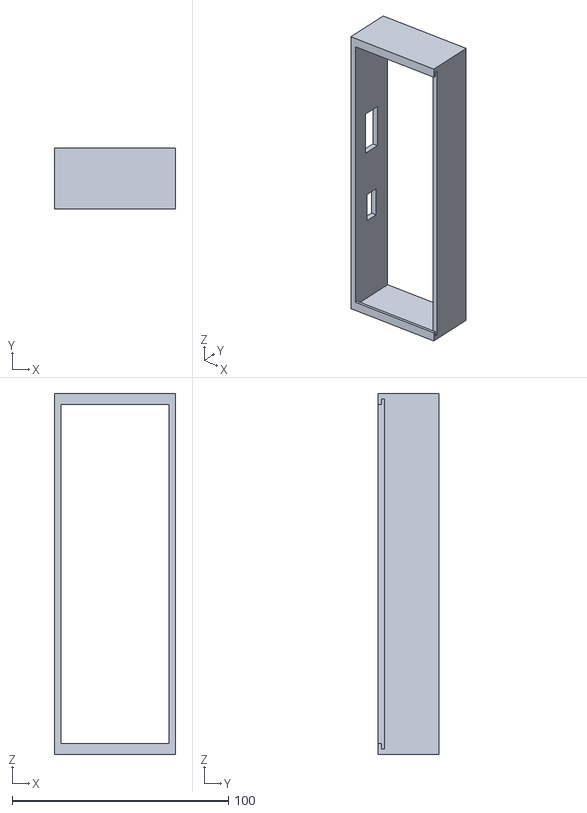
[picture p54: CAD file, 2025-03-24]
Inventor tekeningen/afstandsbediening bakje.stl
56.0 x 28.0 x 167.0
