Nowie69/Eindproject-Robot-6ICW/Inventor tekeningen/afstandsbediening bakjeV3.stl

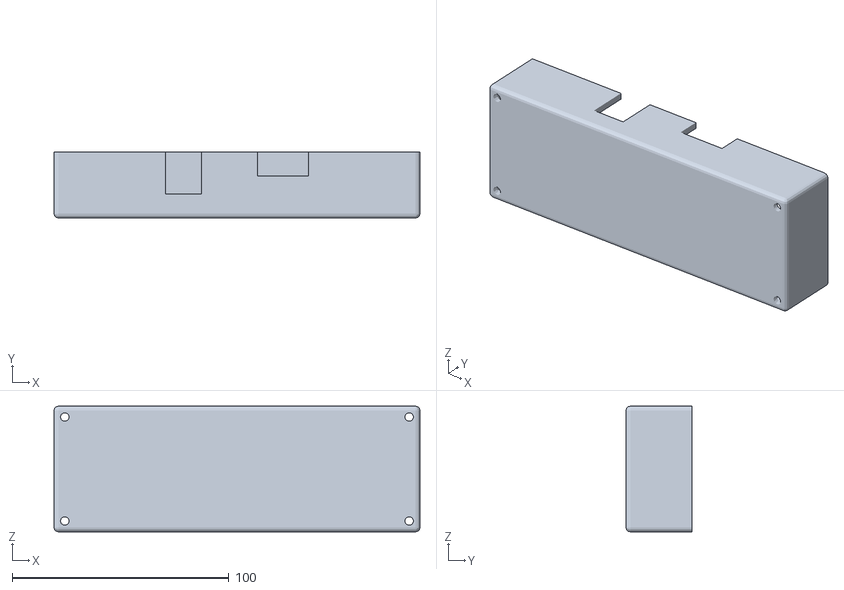
[picture p55: CAD file, 2025-03-24]
Inventor tekeningen/afstandsbediening bakjeV3.stl
169.0 x 30.5 x 58.0
