Nowie69/Eindproject-Robot-6ICW/Inventor tekeningen/afstandsbediening onderplaat.stl

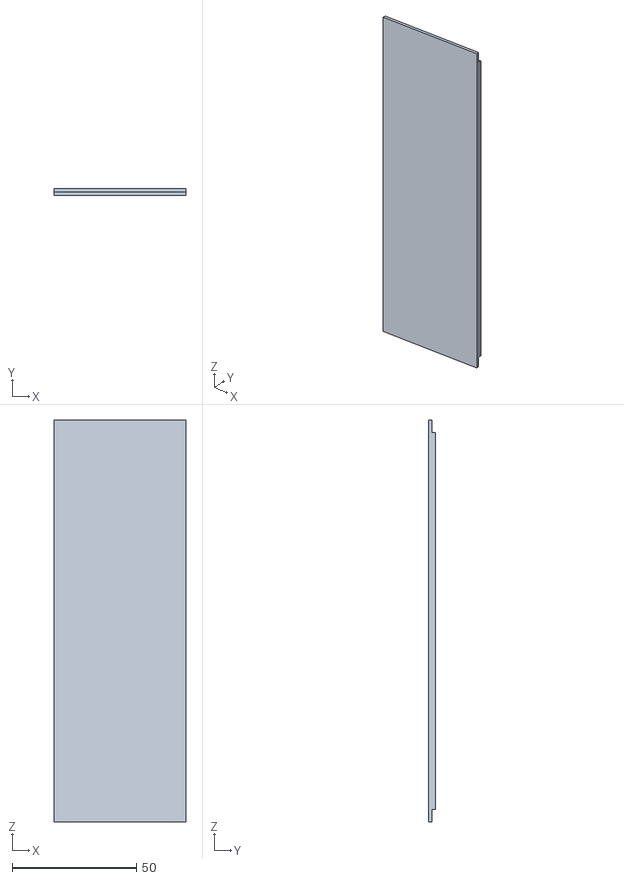
[picture p56: CAD file, 2025-03-24]
Inventor tekeningen/afstandsbediening onderplaat.stl
53.0 x 2.90 x 162.0
