Nowie69/Eindproject-Robot-6ICW/Inventor tekeningen/afstandsbediening bovenplaatV1.stl

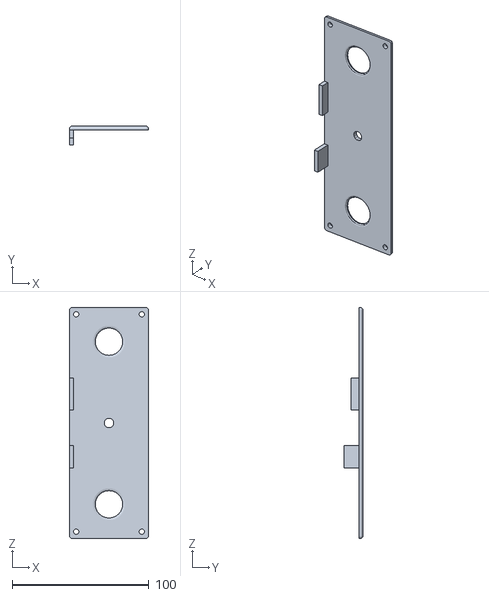
[picture p57: CAD file, 2025-03-24]
Inventor tekeningen/afstandsbediening bovenplaatV1.stl
58.0 x 14.0 x 169.0
