Nowie69/Eindproject-Robot-6ICW/WebsiteV2/-Sjabloon-/images/flowSetup.png

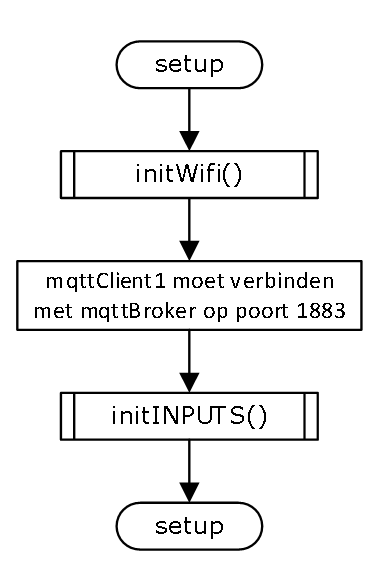
WebsiteV2/-Sjabloon-/images/flowSetup.png
