Nowie69/Eindproject-Robot-6ICW/(commit log)

2025-01-29 alle bestanden toegevoegd en in de juiste mappen geplaatst
2025-01-29 De volledige code van de controller toegevoegd
2025-02-05 Commentaar aan volledige code arduino toegevoegd
2025-02-12 de welkomtekst op de homepagina uit de kader gedaan, was raar
2025-02-13 de volledige css aangepast en de navbar opmaak aangepast en logo van school in de navbar geplaatst, met vriendelijke groenten Dhr. Vandevelde
2025-02-17 Arduino code van controller juist aangepast
2025-03-24 inventor tekeningen toegevoegd
    [Part1.0001.ipt, Part1.ipt, Part2.0001.ipt, Part2.0002.ipt, Part2.ipt, afstandsbediening bakje.stl, afstandsbediening bakjeV3.stl, afstandsbediening bovenplaatV1.stl]
2025-03-29 controller code en website de werking aangepast
    [knob.stl]
2025-05-03 flowchart gemaakt van code controller en helft van taak 04
2025-05-07 flowcharts geüpdated en nog inventor tekeningen
2025-05-07 da werkt ier nie
    [DekselHBruggen.stl, HouderHBruggen.stl, HouderRaspberryPi.stl, Part1.0001.ipt, Part1.ipt, Part2.0001.ipt, Part2.0002.ipt, Part2.ipt]
2025-05-12 nieuw deksel voor H-bruggen
    [DekselHBruggen.stl]
2025-05-20 Powerpoint toegevoegd
2025-05-27 schema's update
    [POTknop.stl]
2025-05-27 PowerJointje toegevoegd
2025-05-27 Kleine aanpassingen powerjoint
2025-06-03 PowerJoint update
2025-06-04 powerpoint en website beetje
